jaimelaborda/rufus2-robot/README.md

# rufus2-robot

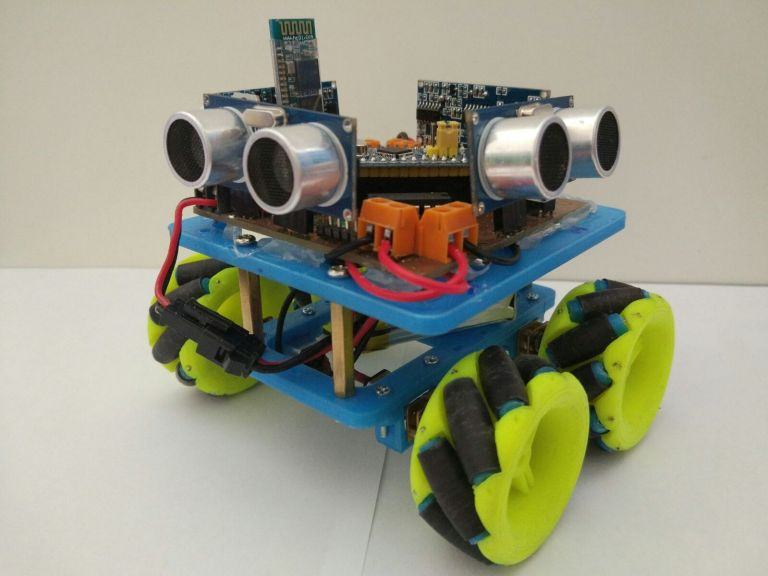
[picture p1: images/rufus2.jpeg]


Rufus is another Arduino robotic platform but based on the STM32F103C microcontroller.
