jaimelaborda/rufus2-robot/android-app/blocks.png

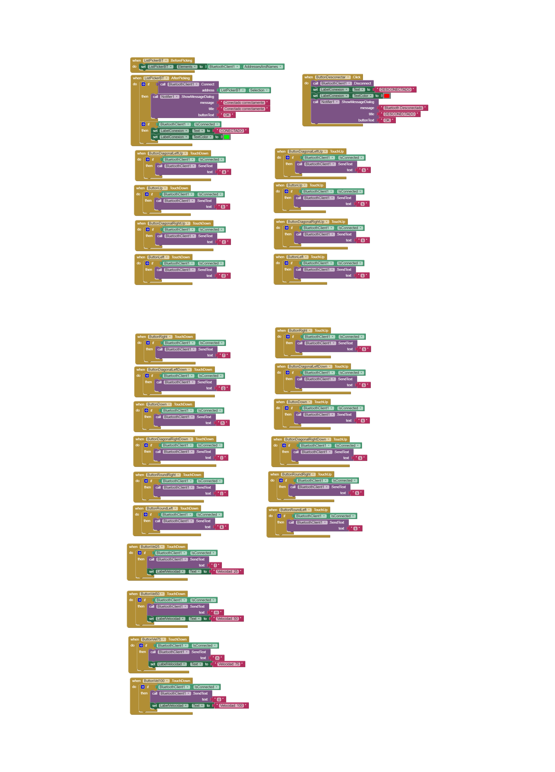
android-app/blocks.png
