jaimelaborda/rufus2-robot/schematic/BOM_MAIN.xlsx

id | value | quantity | package | id | Descripción | Cantidad
1 | ARDUINO NANO | 1 | ARDUINO_NANO | 1 | SENSOR INFRARROJO TCRT5000 | 3
2 | HC-SR04 | 1 | M1X4 | 2 | HC-SR04 ULTRASONIC SENSOR | 1
3 | L293DNE | 2 | DIP16-2.54-19.2X7.62MM | 3 | ARDUINO NANO | 1
4 | BATTERY INPUT - 2SLIPO | 1 | TERMINAL_BLOCK_2P_5 | 4 | MOTOR POLOLU CON REDUCTORA | 3
5 | MOT1 | 1 | TERMINAL_BLOCK_2P_5 | 5 | L293D MOTOR DRIVER H BRIDGE | 2
6 | MOT3 | 1 | TERMINAL_BLOCK_2P_5 | 6 | BATERIA LI-PO 2S 25C 7.4v | 1
7 | HC-05 BLUETOOTH | 1 | M1X6 | 7 | HC-05 BLUETOOTH | 1
8 | MOT2 | 1 | TERMINAL_BLOCK_2P_5 | 8 | BOTÓN PULSADOR | 1
9 | SWITCH-6x6x5_TH | 1 | SWITCH-6X6X5_TH | 9 | LED | 1
10 | SWITCH-SPDT | 1 | SWITCH-SPDT
11 | 22k | 2 | RES 1206 | id | Descripción | Cantidad
12 | CON_HEADER_1X05-PTH | 1 | M1X5 | 1 | CHASIS IMPRESO 3D | 1
13 | 47k | 1 | RES 1206 | 2 | RUEDA OMNIDIRECCIONAL SUECA | 3
14 |  | 1 | LED-3MM/2.54 | 3 | LLANTA RUEDA IMPRESA 3D | 1
15 | 330 | 1 | RES 1206 | 4 | TAPA CHASIS | 1
16 | TCRT5000 | 3 |  | 5
17 | 2N7000 | 1 | TO92-INLINE | 6
18 | 330 | 3 | RES 1206 | 7
19 | 47k | 1 | RES 1206 | 8
20 | 10n | 1 | RAD-0.1 | 9
21 | 1u | 2 | RAD-0.1
22 | 220 | 3 | RES 1206
23 | CON_HEADER_1X05-PTH | 1 | M1X5
