jaimelaborda/rufus2-robot/stl/Top.STL

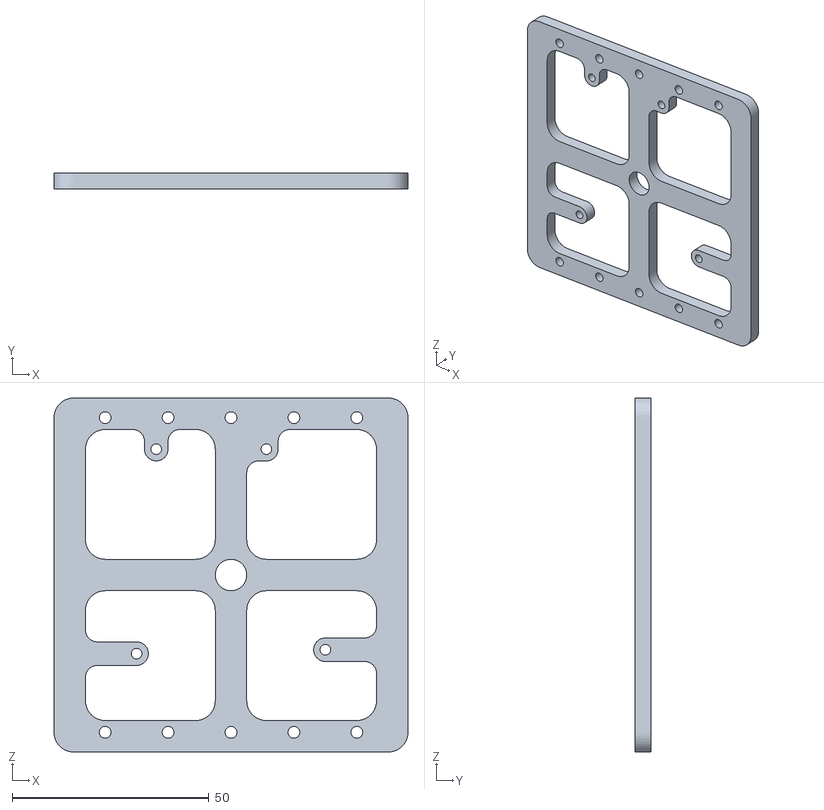
[picture p3: CAD file, 2017-05-06]
stl/Top.STL
90.0 x 4.00 x 90.0
