jaimelaborda/rufus2-robot/stl/Body_Left.STL

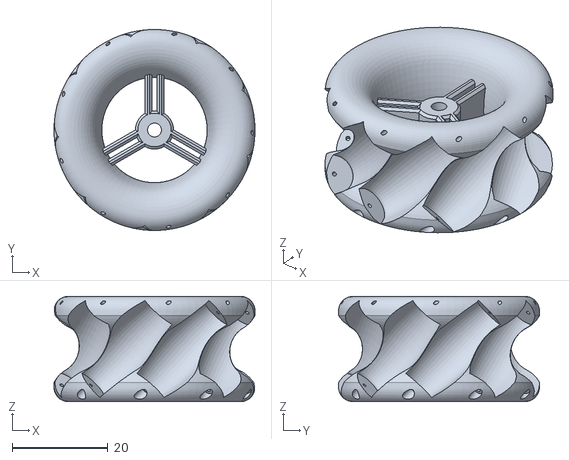
[picture p4: CAD file, 2017-05-06]
stl/Body_Left.STL
42.0 x 42.0 x 22.0
