jaimelaborda/rufus2-robot/stl/Roller.STL

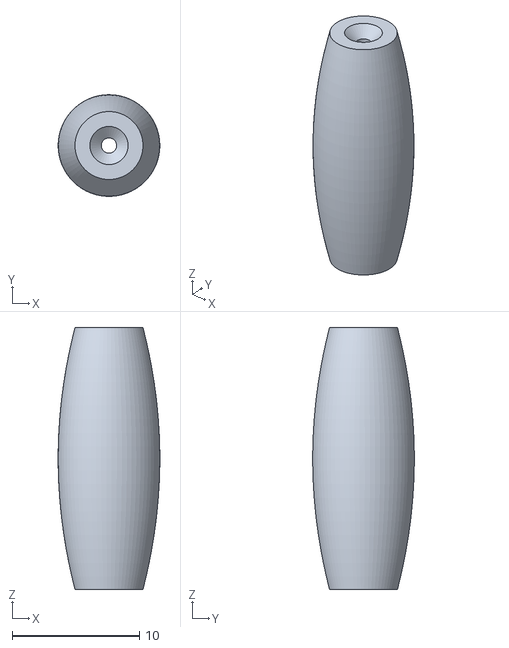
[picture p5: CAD file, 2017-05-06]
stl/Roller.STL
8.00 x 7.99 x 20.6
