jaimelaborda/rufus2-robot/stl/Motor_Mount.STL

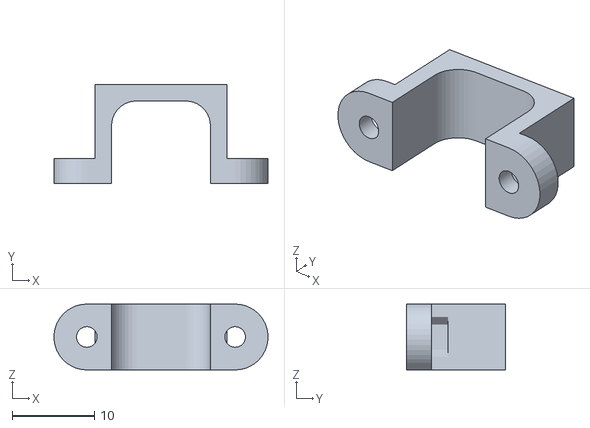
[picture p6: CAD file, 2017-05-06]
stl/Motor_Mount.STL
26.0 x 12.0 x 8.00
