jaimelaborda/rufus2-robot/stl/bottom.STL

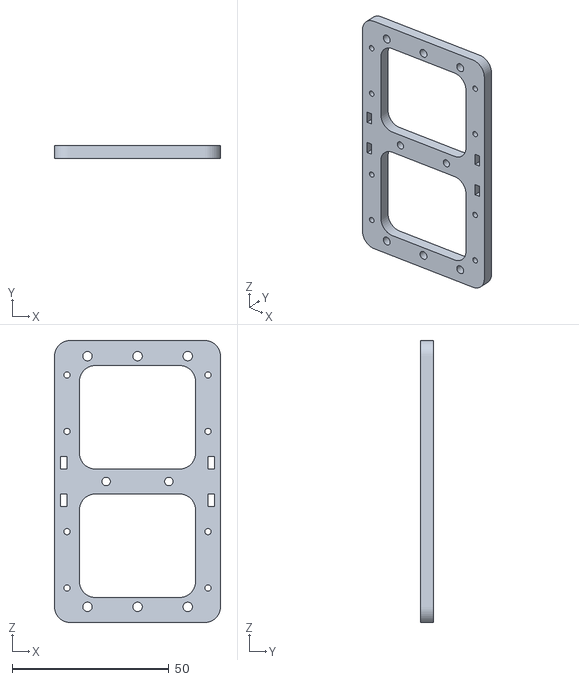
[picture p7: CAD file, 2017-05-06]
stl/bottom.STL
53.0 x 4.00 x 90.0
