jaimelaborda/rufus2-robot/(list of files, cad)

Other CAD files:
stl/Body_Right.STL
