jaimelaborda/rufus2-robot/schematic/IR-sensor-board.pdf

# IR SENSOR BOARD

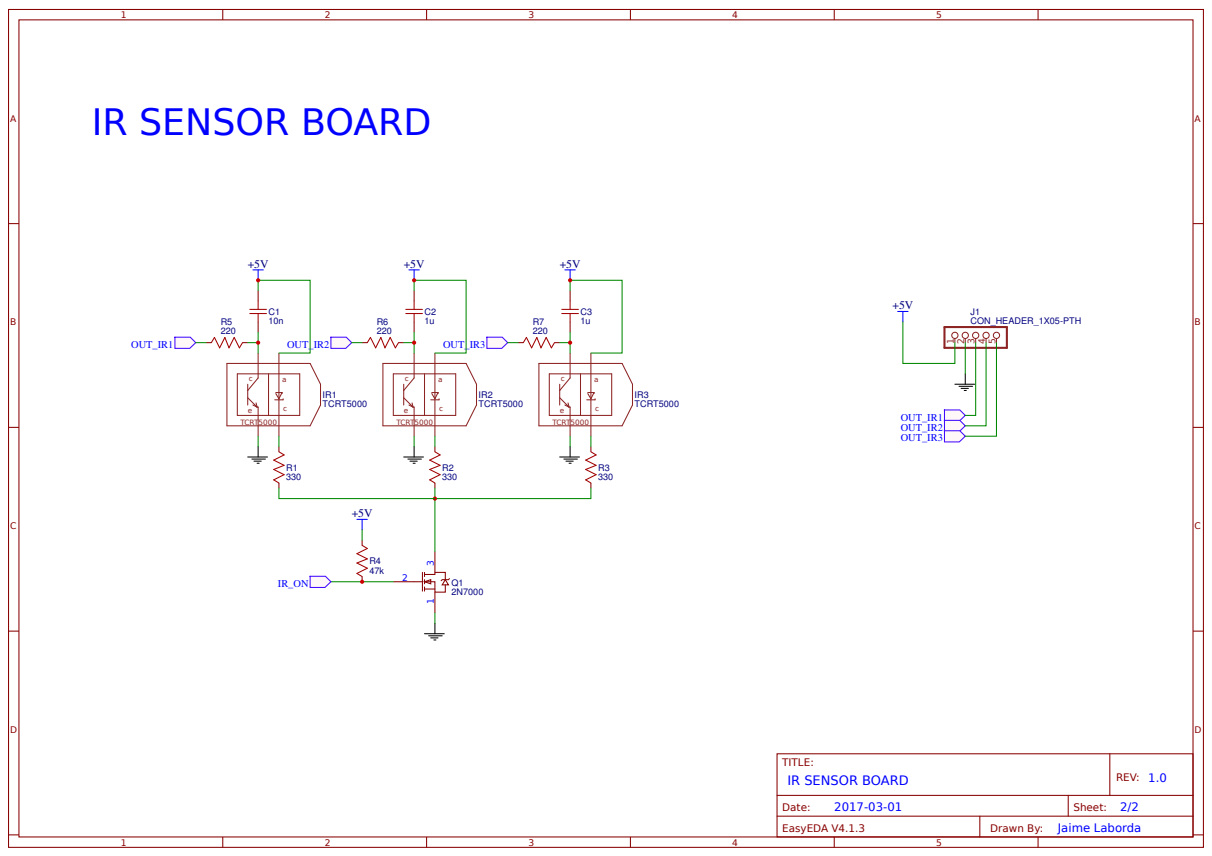
[picture p8: page 1]
