jaimelaborda/rufus2-robot/schematic/Main-Board_sch.pdf

## VBAT

+5V

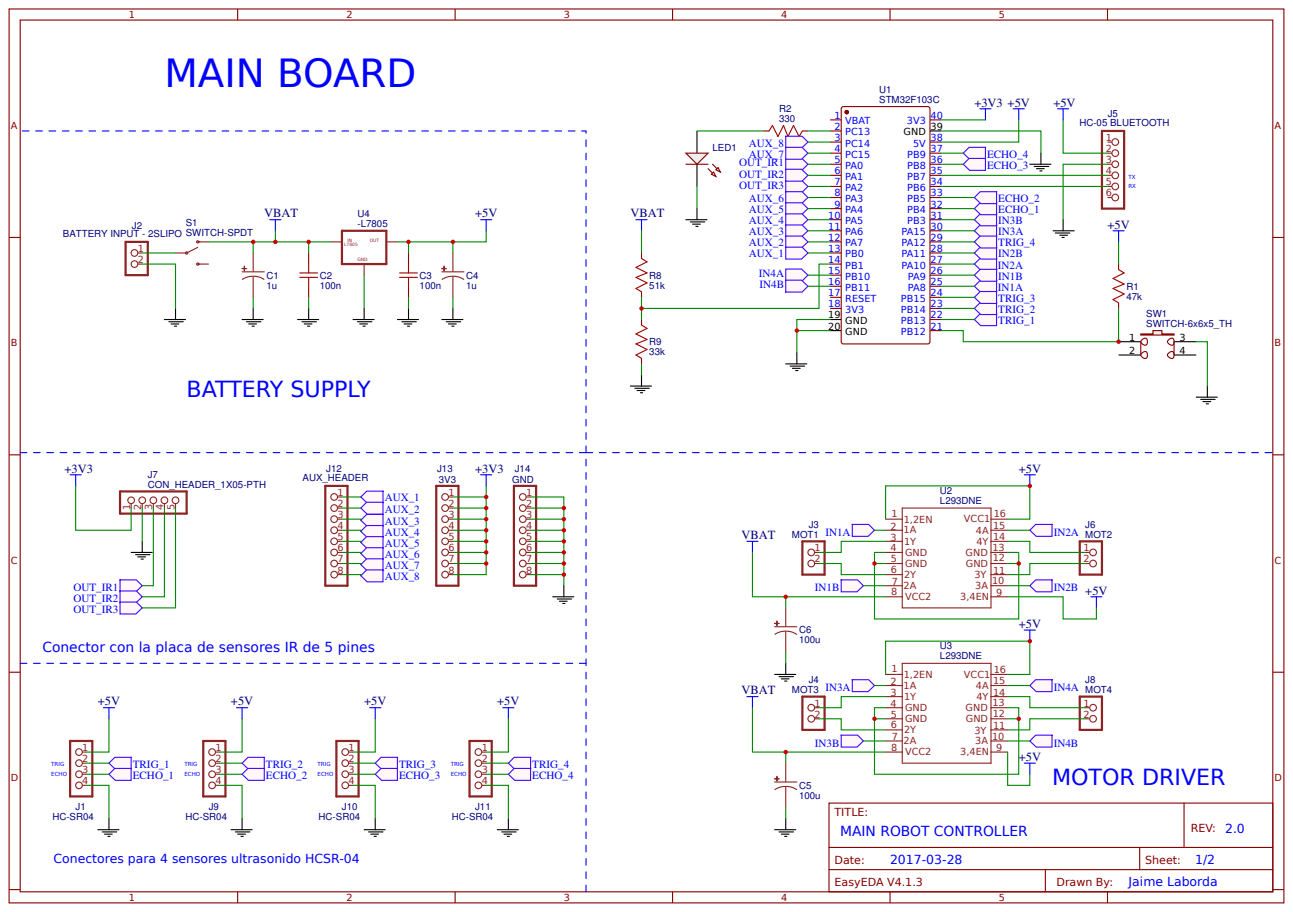
[picture p9: page 1]

Conector con la placa de sensores IR de 5 pines

Conectores para 4 sensores ultrasonido HCSR-04
