jaimelaborda/rufus2-robot/pcb/pcb_merged.pdf

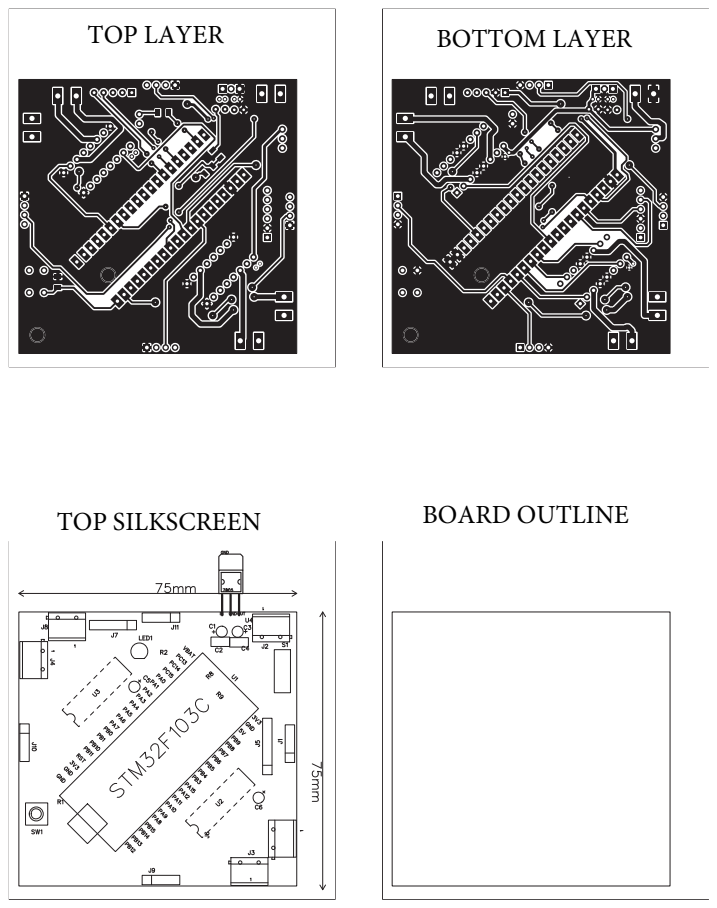
[picture p10: page 1]
TOP LAYER; BOTTOM LAYER; TOP SILKSCREEN; BOARD OUTLINE
