jaimelaborda/rufus2-robot/pcb/botton_layer.pdf

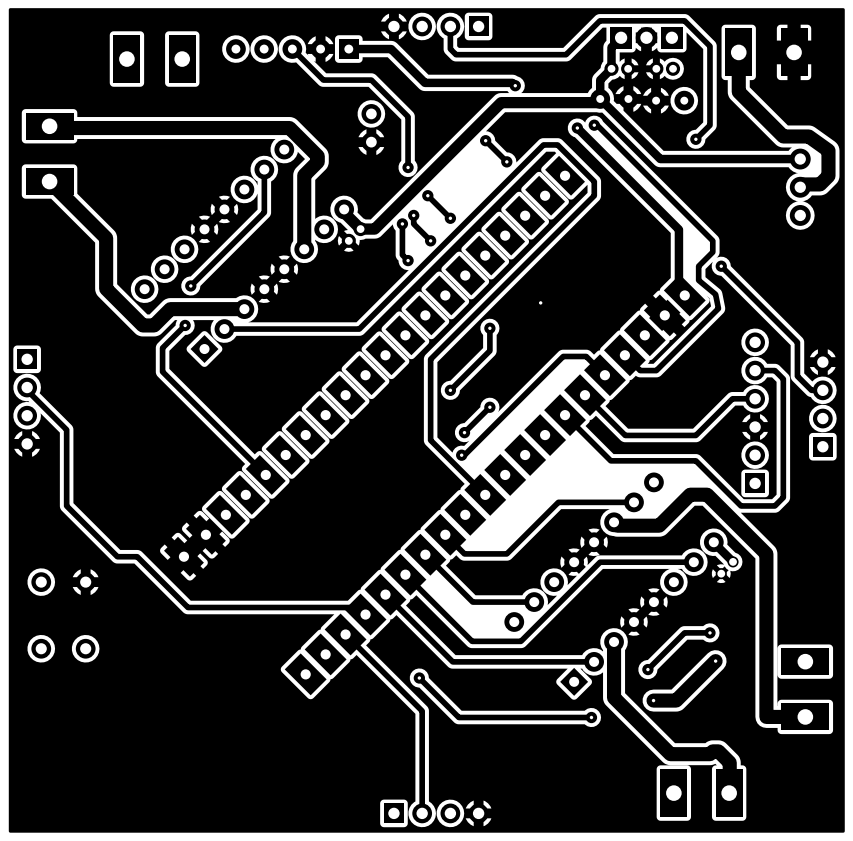
[picture p11: page 1]
