jaimelaborda/rufus2-robot/pcb/top_layer.pdf

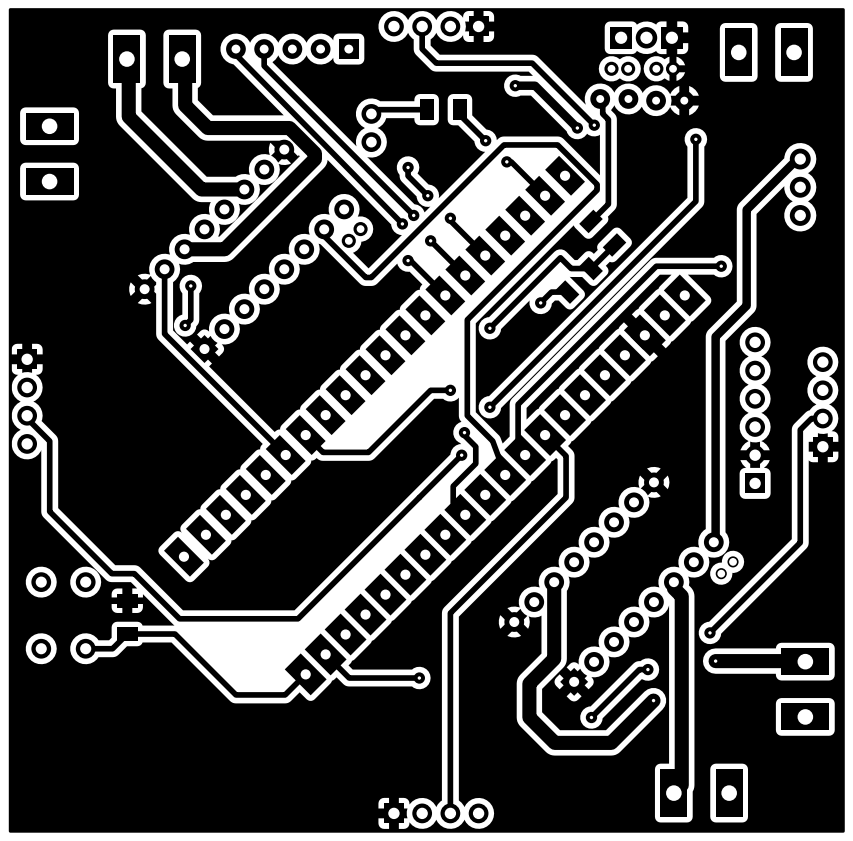
[picture p12: page 1]
