jaimelaborda/rufus2-robot/(threads)

Thread 1 (2017-07-12):

Wrong PWM Connections to the L293 Motor Driver

jaimelaborda, 2017-07-12:
There has been problems with some pins of the STMF1 do to a wrong pinout of the board. It has been corrected on the first prototype with mod wires, but it is left to update Schematic, generate netlist, and re-route the PCB. DO NOT TRUST THE CONNECTIONS.
